arpan379/UWB-Based-Positioning-and-Motion-Tracking-PCB/Schematic_diagram/SCH_Schematic.pdf

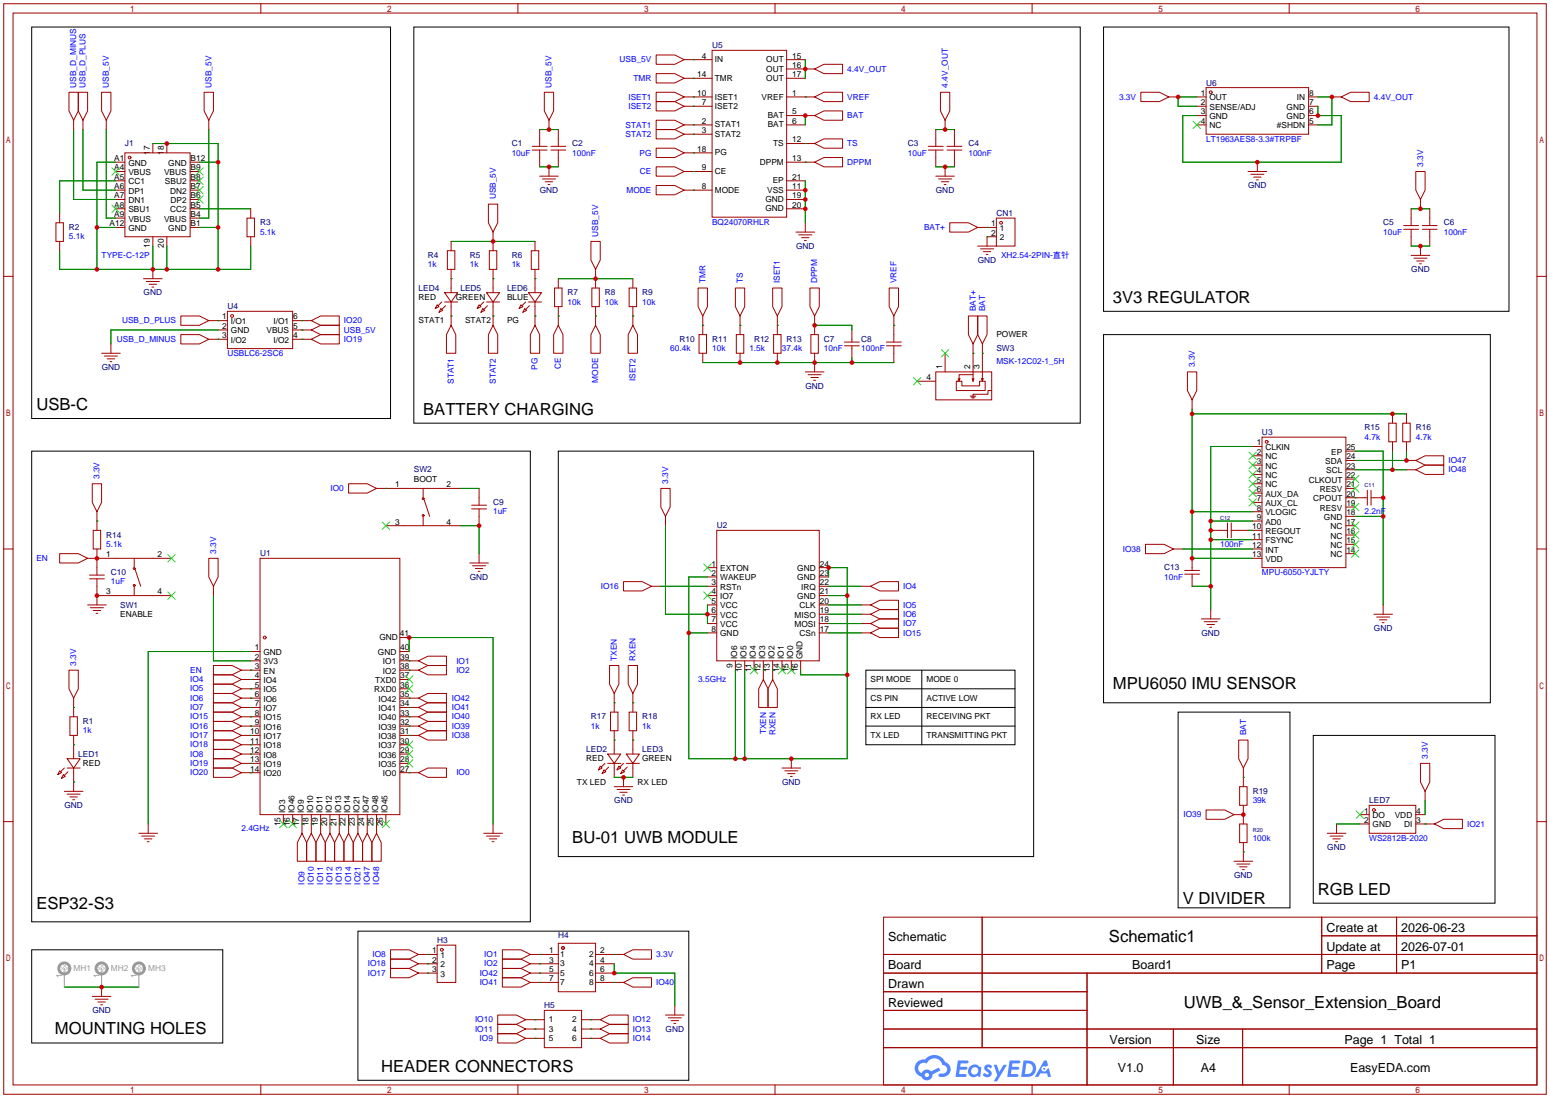
[picture p20: page 1]

GND B1 GND A12 VBUS A9 SBU1 A8 DN1 A7 DP1 A6 CC1 A5 VBUS A4 GND A1

CSn 17 MOSI 18 MISO 19 CLK 20 GND 21 IRQ 22 GND 23 GND 24

Schematic | Schematic1 | Create at | 2026-06-23

Update at | 2026-07-01

Board | Board1 | Page | P1

Version | Size | Page 1 Total 1
V1.0 | A4 | EasyEDA.com
