arpan379/UWB-Based-Positioning-and-Motion-Tracking-PCB/(list of files, drawings)

Other design files:
UWB_&_Sensor_Extension_Board.eprj
