arpan379/UWB-Based-Positioning-and-Motion-Tracking-PCB/(commit log)

2026-07-14 Required gerber files
2026-07-14 Easy EDA pro files
    [UWB_&_Sensor_Extension_Board.eprj]
2026-07-14 Schematic diagram image
2026-07-14 Schematic diagram pdfe
