arpan379/UWB-Based-Positioning-and-Motion-Tracking-PCB/(notices)

Notices in the files:
README.md:
License: MIT
